Saniro1/Gamesir-G7-Pro-Gyro-Mount/docs/V28_README.md

# GameSir G7 Pro modular reversible gyro mount

**V28 is the current revision:** a smoothly rounded transition replaces the pointed V27 join. The **V27 box position**, **9 mm clips**, **5 mm receiver inset**, **8 mm upper-bridge clearance**, and **thin straight print supports** are retained.

The owner asked for a rounder, more natural-looking curve. V28 uses a rounded crown and a continuous swept-band return, keeping the box position and functional clearances from V27. The revised fit has not yet been physically tested; print the short hook coupon first.

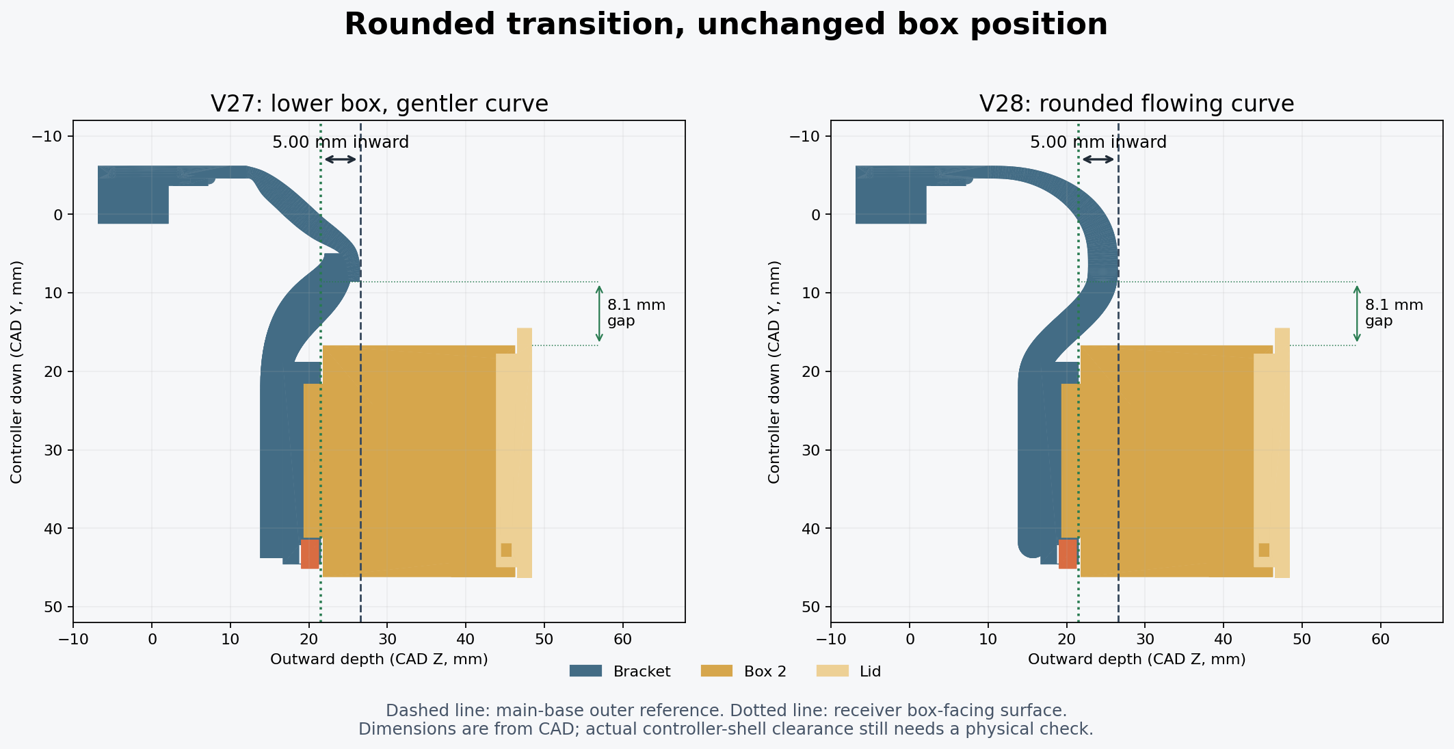
[picture p12: docs/V28_receiver_inset.png]
Receiver face inset relative to the main base


## Download and print

- [Snapmaker U1 0.4 mm / Snapmaker PLA Black — supported V28 3MF](slicer/Snapmaker_U1_PLA_Black_0.4_V28/G7_Modular_v28_U1_0.4_Snapmaker_PLA_Black_Supported.3mf)
- [Editable, unsliced V28 project](slicer/Snapmaker_U1_PLA_Black_0.4_V28/G7_Modular_v28_U1_0.4_Snapmaker_PLA_Black.3mf)
- [Complete V28 ZIP](releases/G7_Pro_Modular_Reversible_Box2_V28_Complete.zip)
- [Revised attachment STL](printable/G7_Modular_v28_g7_mount.stl) and [9 mm hook test STL](printable/G7_Modular_v28_hook_fit_coupon.stl)

Open the 3MF **as a project** in Snapmaker Orca 2.4.1 or newer. The supported file includes cached toolpaths and supports; inspect them in Preview. Re-slice if you change anything.

Plate 1 contains the revised hook test, receiver, dovetail coupon and key. Plate 2 contains the complete four-part assembly. **The Box 2 enclosure, lid, key and dovetail profile are unchanged from V23**; reuse those prints if you already have them. To print only the revised attachment, select that object and re-slice rather than sending the cached full-plate job.

## Current geometry

- Trimmed 1 mm from the free ends of both top clips: 10 mm becomes 9 mm. No global scaling or thinning of their sides.
- Lowered the complete dock/box/key installation 10 mm from V26, leaving it 30 mm above V23.
- Kept the receiver face 5 mm inward of the main-base reference. A rounded shared crown joins the upper bridge and lower links without the pointed V27 corner; the lower return has a consistent 3.8 mm side-profile thickness. Upper-bridge clearance remains at least 8 mm in both USB orientations.
- Removed the old long arms and lower dock, and joined the raised receiver with short structural arms.
- Used sparse straight rectilinear print supports (normal/snug, 3 mm line spacing), 0.32 mm separation and a sparse interface. No tree supports.

The structural arms are permanent parts of the attachment. The thin print supports shown in the slicer preview are removable. See [revision measurements and validation](docs/V28_REVISION.md) and [U1 setup details](slicer/Snapmaker_U1_PLA_Black_0.4_V28/README.md).

The controller shell, rear buttons, triggers and cable routes still need a physical check at this new position. Check the short hook first and then the complete mount without loading the device. PLA flexure durability and the strength of the bracket/key have not been physically verified.

## Files and history

V28 CAD is in [cad/G7_Pro_Modular_v28.scad](cad/G7_Pro_Modular_v28.scad); its seven STLs are in `printable/`, and both assembly views are in `assemblies/`. The V28 CAD reuses the frozen V24 9 mm clip geometry and V23 interface meshes. Its swept upper band tapers smoothly from the unchanged clip root to a rounded crown; the lower band flows from that shared crown to the receiver. The controller-contact clip surfaces remain unchanged.

The complete original V22 ZIP and all 13 extracted files remain unchanged under `originals/`. V23 through V27 source, prints and projects are retained for history, including the [V23 instructions](docs/V23_README.md). **Use V28 filenames for this revision.** No license was supplied with the original files; this import does not assert ownership or grant a new license.

## Rebuild

Use the existing checkout; no Git worktree is needed. Requires OpenSCAD 2021.01 and Python 3.12:

```bash
python -m venv .venv
.venv/bin/python -m pip install -r tools/requirements.txt
source .venv/bin/activate
./tools/build.sh 28
```

The build exports all seven V28 meshes and runs the geometry/assembly checks, writing `docs/validation_v28.json`. Explicitly use `./tools/build.sh 23` to reproduce the old version.

To regenerate the U1 projects and validate the saved file in the actual slicer:

```bash
.venv/bin/python tools/create_snapmaker_orca_project.py --design-version 28 \
  --resources /path/to/SnapmakerOrca/resources \
  --orca /path/to/snapmaker-orca --workdir /tmp/g7-u1-v28 --validate
python tools/package_release.py --design-version 28
```

The saved V28 project passed 84 project/slicing checks, and the V28 geometry passed 97 CAD checks. These establish model and slicer consistency, not physical fit or a load rating.
