Saniro1/Gamesir-G7-Pro-Gyro-Mount/docs/V27_comparison.png

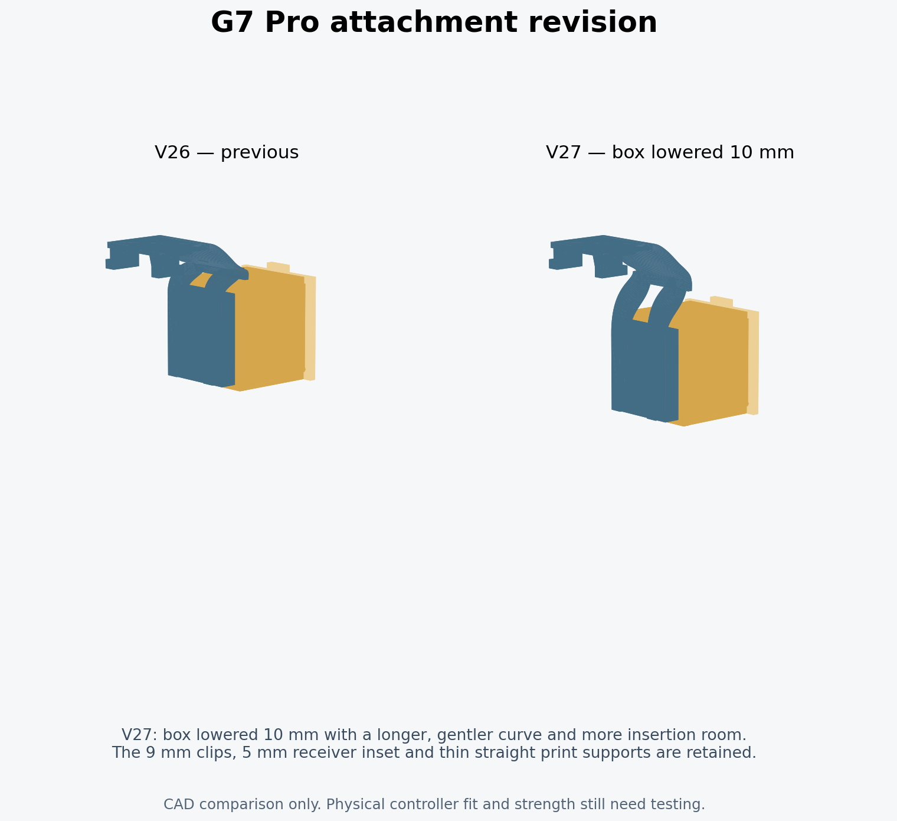
docs/V27_comparison.png
