Saniro1/Gamesir-G7-Pro-Gyro-Mount/originals/v22/G7_Modular_v22_USB_Up_Down_Preview.png

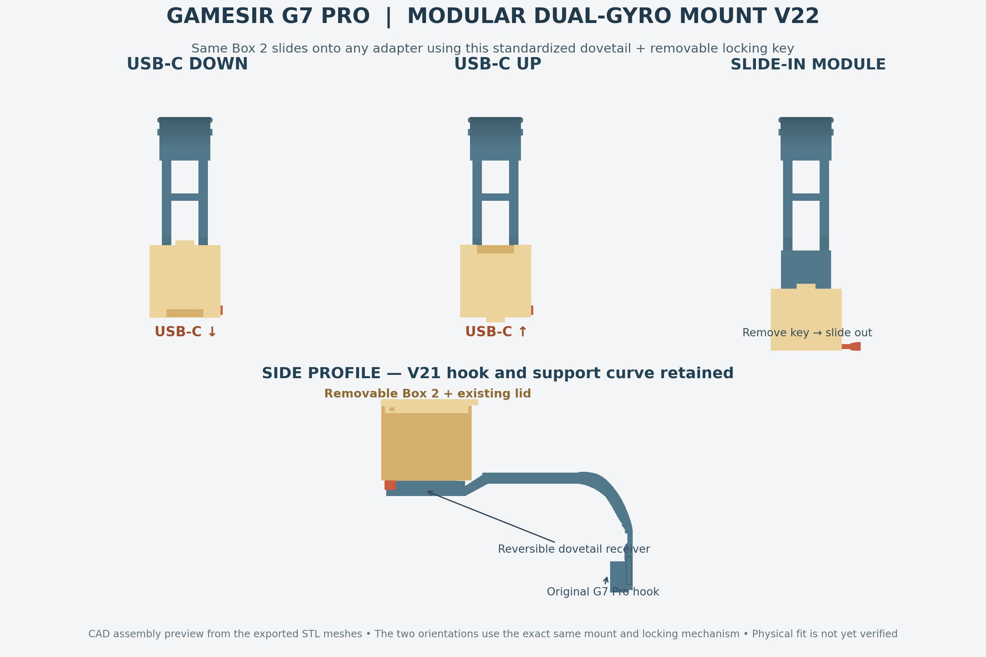
originals/v22/G7_Modular_v22_USB_Up_Down_Preview.png
