Saniro1/Gamesir-G7-Pro-Gyro-Mount/assemblies/G7_Modular_v34_Assembly_USB_Down.3mf

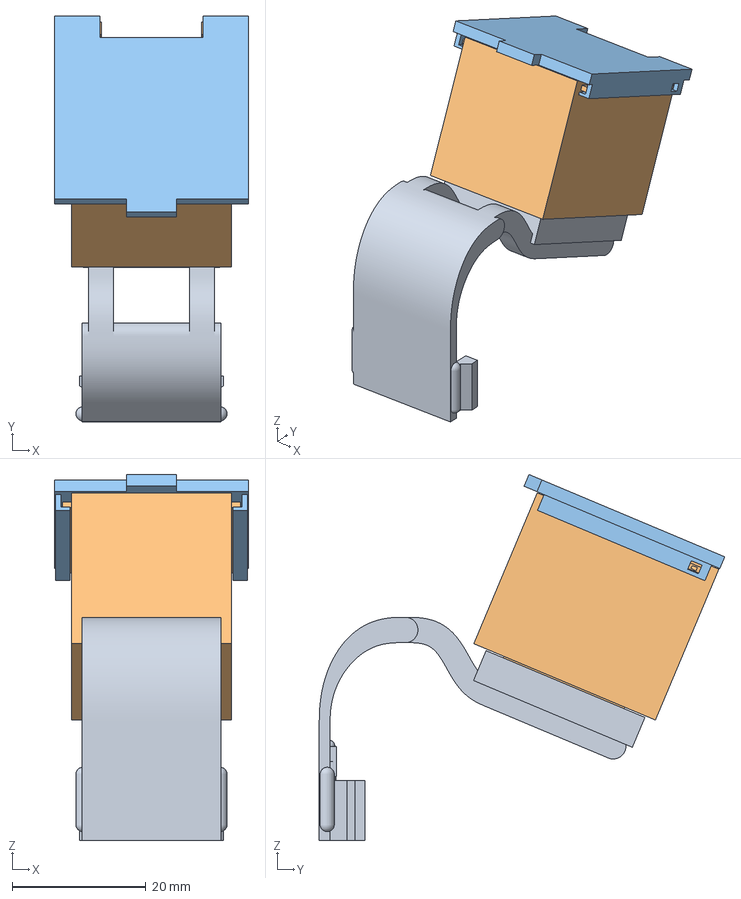
[picture p19: CAD file, 2026-11-11]
assemblies/G7_Modular_v34_Assembly_USB_Down.3mf
29.1 x 60.7 x 54.8 mm
g7_mount
lid
