Saniro1/Gamesir-G7-Pro-Gyro-Mount/originals/v22/G7_Modular_v22_Assembly_USB_Down.3mf

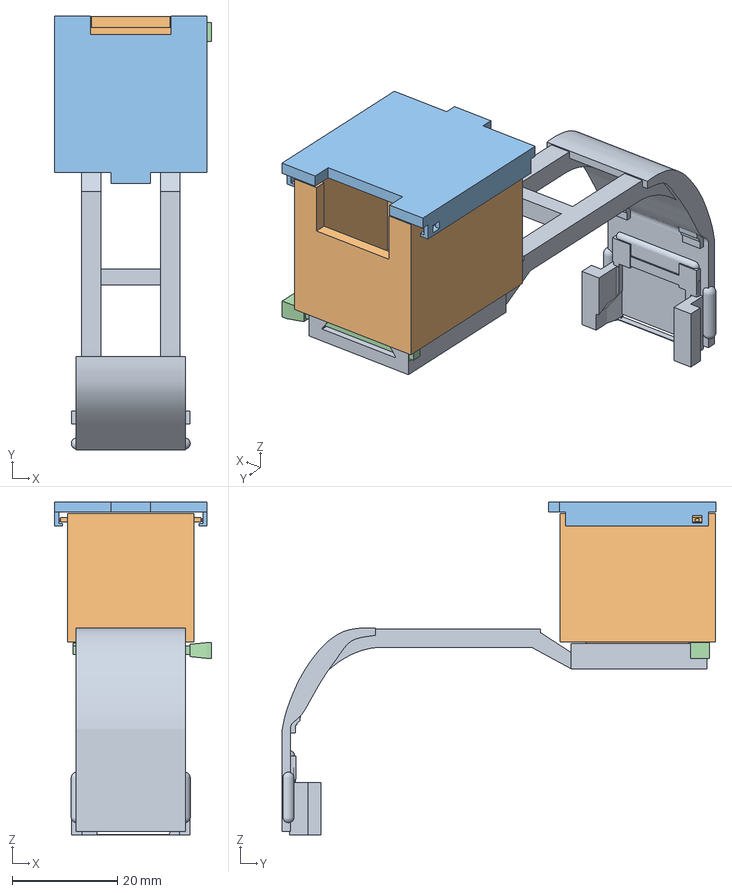
[picture p20: CAD file, 2026-11-05]
originals/v22/G7_Modular_v22_Assembly_USB_Down.3mf
29.9 x 82.5 x 63.4 mm
G7_dock
Box_2_universal_dovetail_reversible
Existing_sliding_lid
lock_key
