Saniro1/Gamesir-G7-Pro-Gyro-Mount/assemblies/G7_Modular_v34_Assembly_USB_Up.3mf

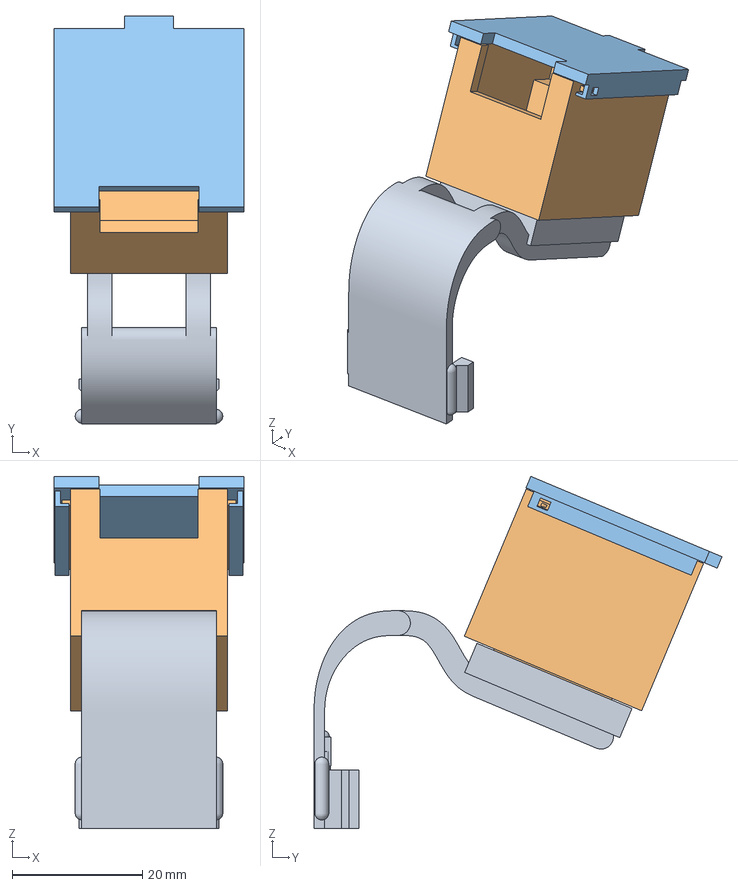
[picture p21: CAD file, 2026-11-11]
assemblies/G7_Modular_v34_Assembly_USB_Up.3mf
29.1 x 62.6 x 54.0 mm
g7_mount
lid
