Saniro1/Gamesir-G7-Pro-Gyro-Mount/cad/reference/mount_v22.stl

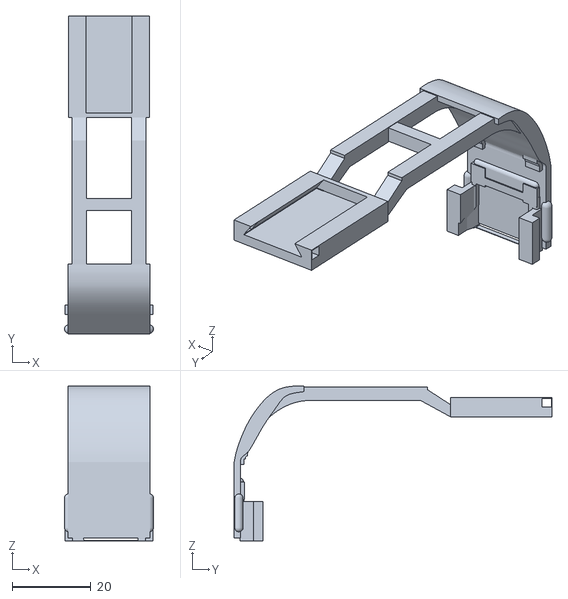
[picture p23: CAD file, 2026-11-05]
cad/reference/mount_v22.stl
22.6 x 80.8 x 39.4
