Saniro1/Gamesir-G7-Pro-Gyro-Mount/originals/v22/G7_Modular_v22_Print_Ready_4_Parts.3mf

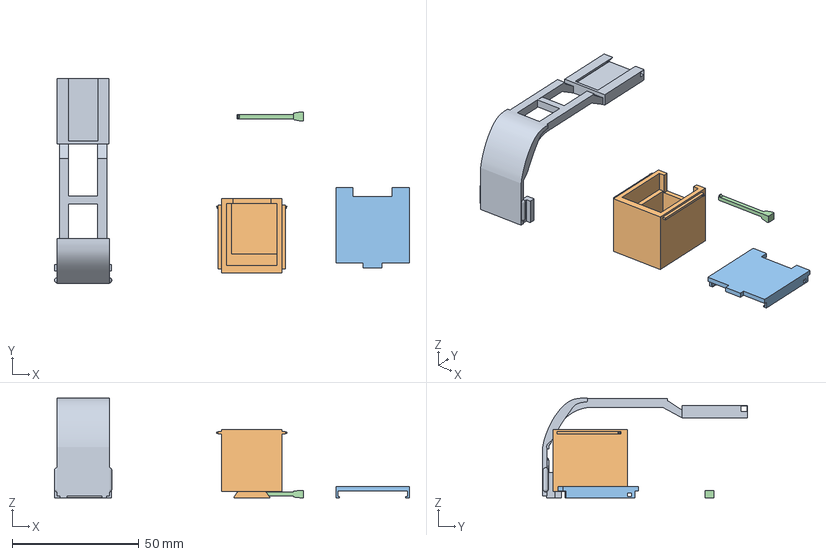
[picture p24: CAD file, 2026-11-05]
originals/v22/G7_Modular_v22_Print_Ready_4_Parts.3mf
140.1 x 80.8 x 39.4 mm
g7_mount
lid
lock_key
