Saniro1/Gamesir-G7-Pro-Gyro-Mount/printable/G7_Modular_v34_g7_mount.stl

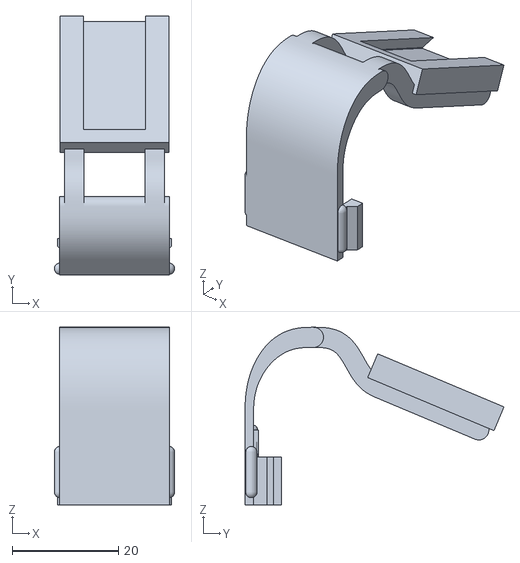
[picture p25: CAD file, 2026-11-11]
printable/G7_Modular_v34_g7_mount.stl
22.6 x 48.8 x 33.4
