Saniro1/Gamesir-G7-Pro-Gyro-Mount/slicer/Snapmaker_U1_IEMAI_Matte_PETG_Black_0.4_V32/G7_Modular_v32_U1_0.4_IEMAI_Matte_PETG_Black_Supported.3mf

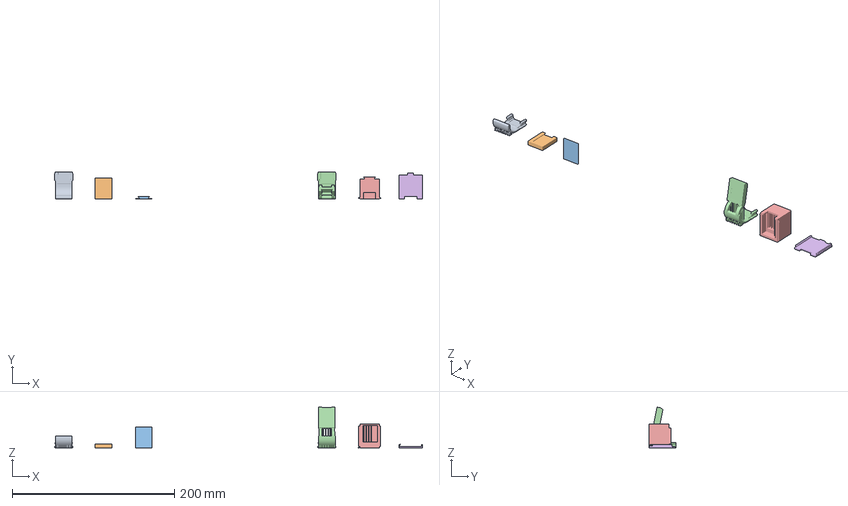
[picture p26: CAD file, 2026-11-10]
slicer/Snapmaker_U1_IEMAI_Matte_PETG_Black_0.4_V32/G7_Modular_v32_U1_0.4_IEMAI_Matte_PETG_Black_Supported.3mf
453.1 x 33.4 x 50.3 mm
hook_fit_coupon._1
universal_receiver._1
male_fit_coupon._1
g7_mount._1
lid._1
