Saniro1/Gamesir-G7-Pro-Gyro-Mount/slicer/Snapmaker_U1_PLA_Black_0.4_V34/custom_supports/g7_mount_peel_sheets.stl

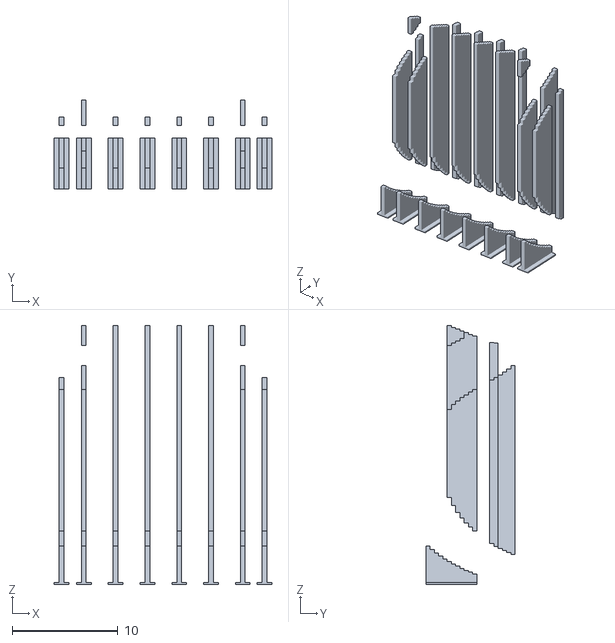
[picture p27: CAD file, 2026-11-11]
slicer/Snapmaker_U1_PLA_Black_0.4_V34/custom_supports/g7_mount_peel_sheets.stl
20.5 x 8.40 x 24.4
