Saniro1/Gamesir-G7-Pro-Gyro-Mount/slicer/Snapmaker_U1_PLA_Black_0.4_V34/G7_Modular_v34_U1_0.4_Snapmaker_PLA_Black.3mf

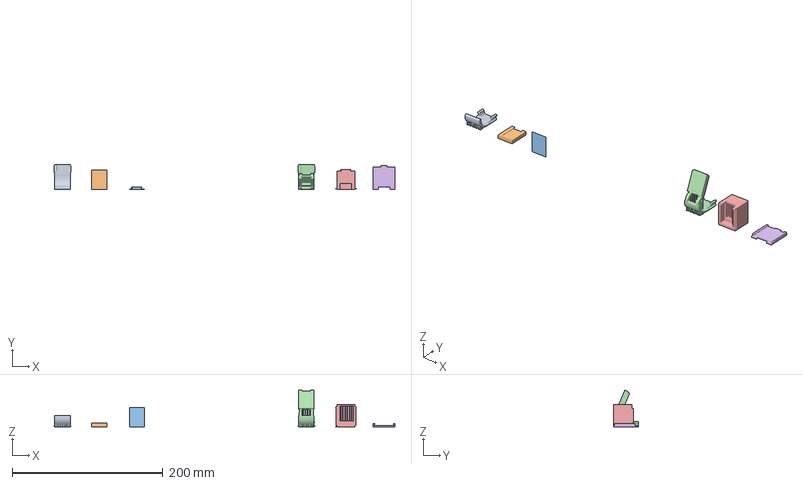
[picture p28: CAD file, 2026-11-11]
slicer/Snapmaker_U1_PLA_Black_0.4_V34/G7_Modular_v34_U1_0.4_Snapmaker_PLA_Black.3mf
453.1 x 33.4 x 48.8 mm
hook_fit_coupon._1
universal_receiver._1
male_fit_coupon._1
g7_mount._1
lid._1
