Saniro1/Gamesir-G7-Pro-Gyro-Mount/assemblies/G7_Modular_v34_Separated_6_Parts.3mf

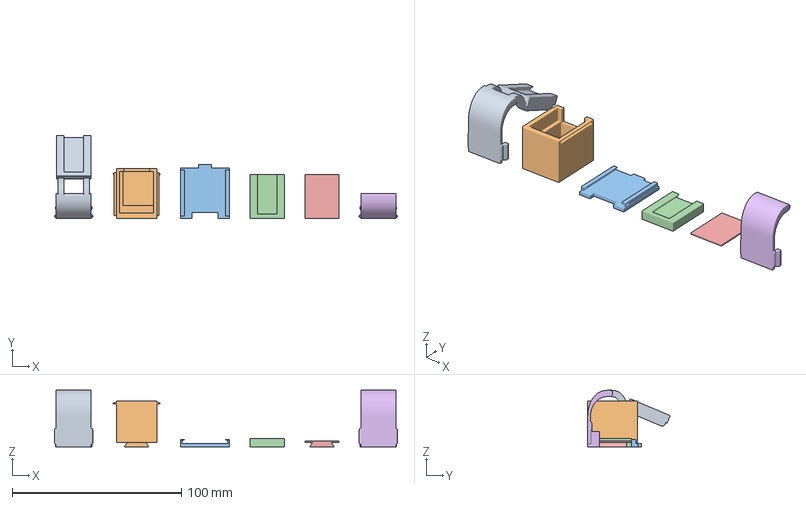
[picture p29: CAD file, 2026-11-11]
assemblies/G7_Modular_v34_Separated_6_Parts.3mf
202.6 x 48.8 x 33.4 mm
g7_mount
lid
universal_receiver
male_fit_coupon
hook_fit_coupon
