Saniro1/Gamesir-G7-Pro-Gyro-Mount/printable/G7_Modular_v34_lid.stl

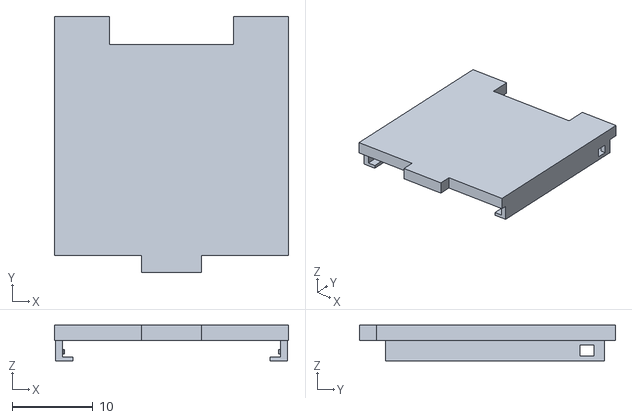
[picture p30: CAD file, 2026-11-11]
printable/G7_Modular_v34_lid.stl
29.1 x 31.8 x 4.45
