Saniro1/Gamesir-G7-Pro-Gyro-Mount/slicer/Snapmaker_U1_PLA_Black_0.4_V34/custom_supports/lid_peel_sheets.stl

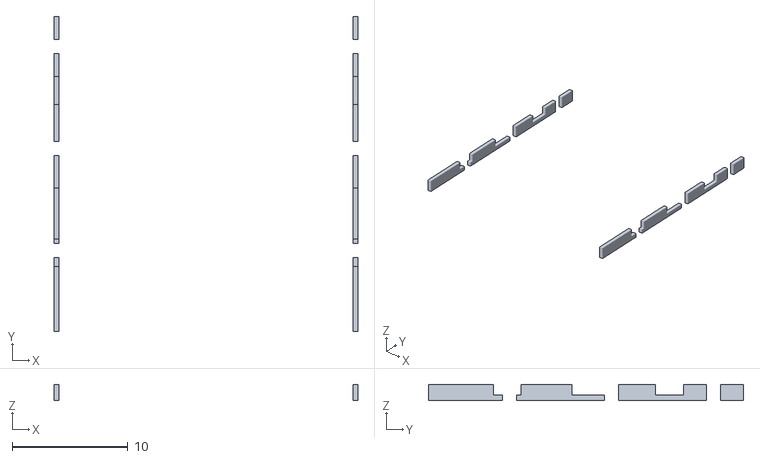
[picture p31: CAD file, 2026-11-11]
slicer/Snapmaker_U1_PLA_Black_0.4_V34/custom_supports/lid_peel_sheets.stl
26.2 x 27.2 x 1.41
