Saniro1/Gamesir-G7-Pro-Gyro-Mount/originals/v22/G7_Modular_v22_lock_key.stl

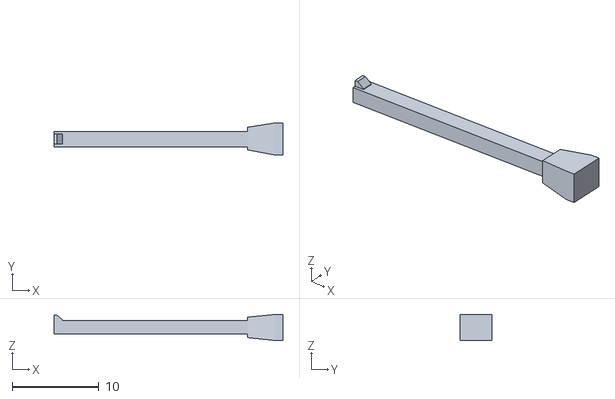
[picture p32: CAD file, 2026-11-05]
originals/v22/G7_Modular_v22_lock_key.stl
26.4 x 3.70 x 3.00
