Saniro1/Gamesir-G7-Pro-Gyro-Mount/printable/G7_Modular_v34_universal_receiver.stl

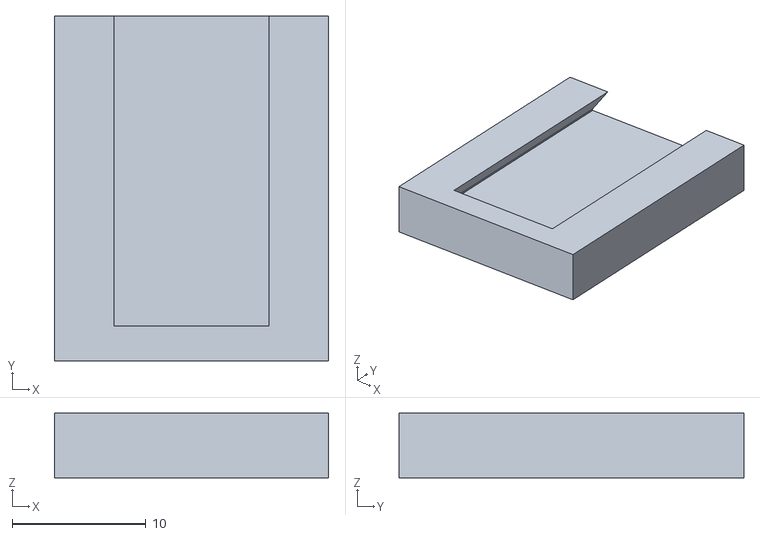
[picture p33: CAD file, 2026-11-10]
printable/G7_Modular_v34_universal_receiver.stl
20.5 x 25.8 x 4.85
