Saniro1/Gamesir-G7-Pro-Gyro-Mount/slicer/Snapmaker_U1_PLA_Black_0.4_V34/custom_supports/hook_fit_coupon_peel_sheets.stl

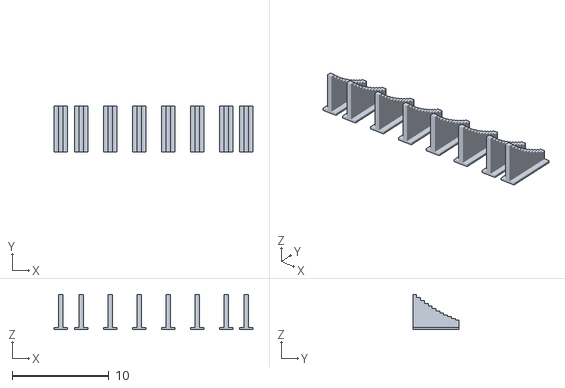
[picture p34: CAD file, 2026-11-10]
slicer/Snapmaker_U1_PLA_Black_0.4_V34/custom_supports/hook_fit_coupon_peel_sheets.stl
20.5 x 4.80 x 3.64
