Saniro1/Gamesir-G7-Pro-Gyro-Mount/originals/v22/G7_Modular_v22_universal_receiver.stl

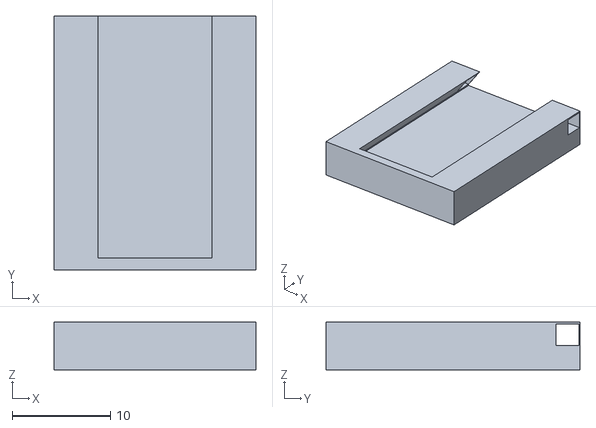
[picture p35: CAD file, 2026-11-05]
originals/v22/G7_Modular_v22_universal_receiver.stl
20.5 x 25.8 x 4.85
