Saniro1/Gamesir-G7-Pro-Gyro-Mount/slicer/Snapmaker_U1_PLA_Black_0.4_V34/custom_supports/male_fit_coupon_peel_sheets.stl

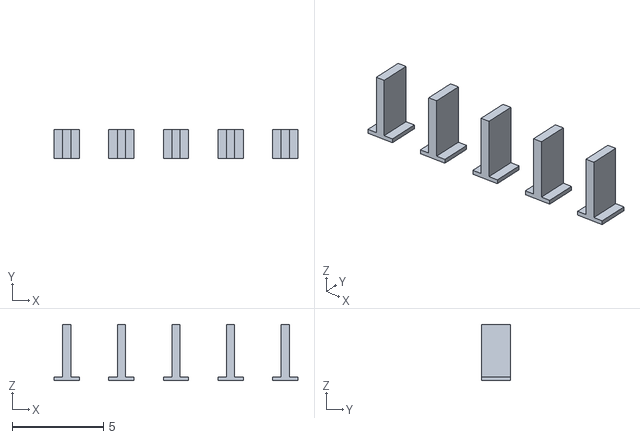
[picture p36: CAD file, 2026-11-10]
slicer/Snapmaker_U1_PLA_Black_0.4_V34/custom_supports/male_fit_coupon_peel_sheets.stl
13.4 x 1.60 x 3.08
