Saniro1/Gamesir-G7-Pro-Gyro-Mount/slicer/Snapmaker_U1_PLA_Black_0.4_V34/custom_supports/box_peel_sheets.stl

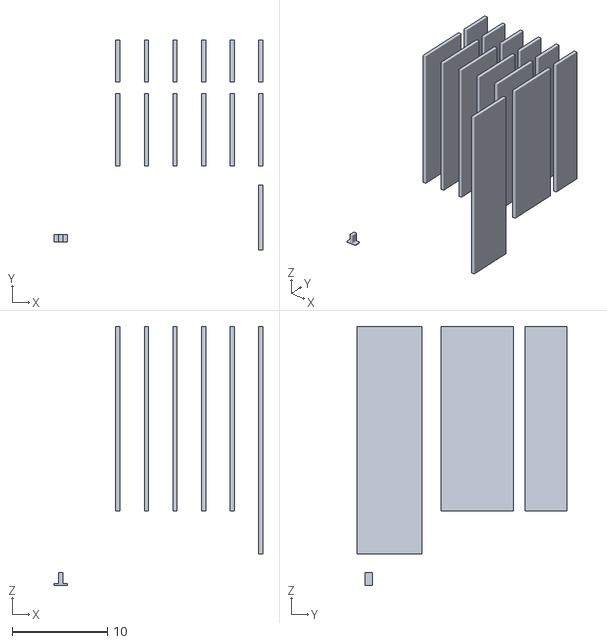
[picture p37: CAD file, 2026-11-10]
slicer/Snapmaker_U1_PLA_Black_0.4_V34/custom_supports/box_peel_sheets.stl
21.9 x 22.0 x 27.2
