Saniro1/Gamesir-G7-Pro-Gyro-Mount/printable/G7_Modular_v34_hook_fit_coupon.stl

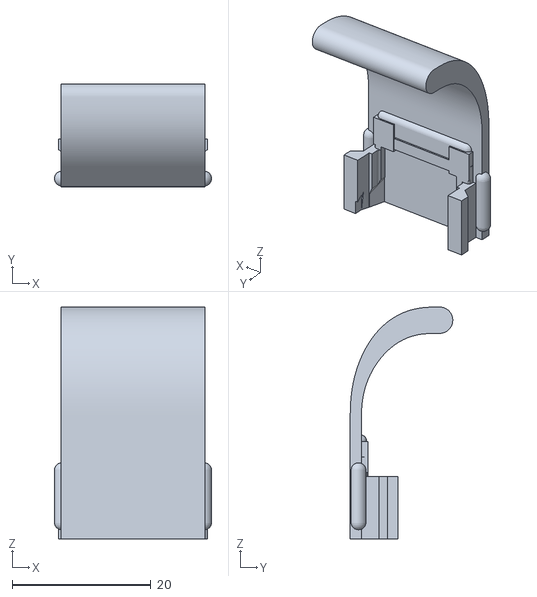
[picture p38: CAD file, 2026-11-10]
printable/G7_Modular_v34_hook_fit_coupon.stl
22.6 x 14.8 x 33.4
