Saniro1/Gamesir-G7-Pro-Gyro-Mount/printable/G7_Modular_v34_box.stl

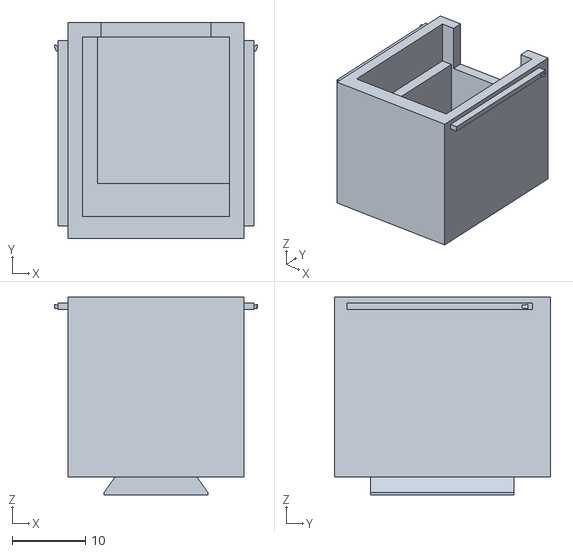
[picture p39: CAD file, 2026-11-10]
printable/G7_Modular_v34_box.stl
27.7 x 29.5 x 27.0
