Saniro1/Gamesir-G7-Pro-Gyro-Mount/assemblies/G7_Modular_v31_Separated_7_Parts.3mf

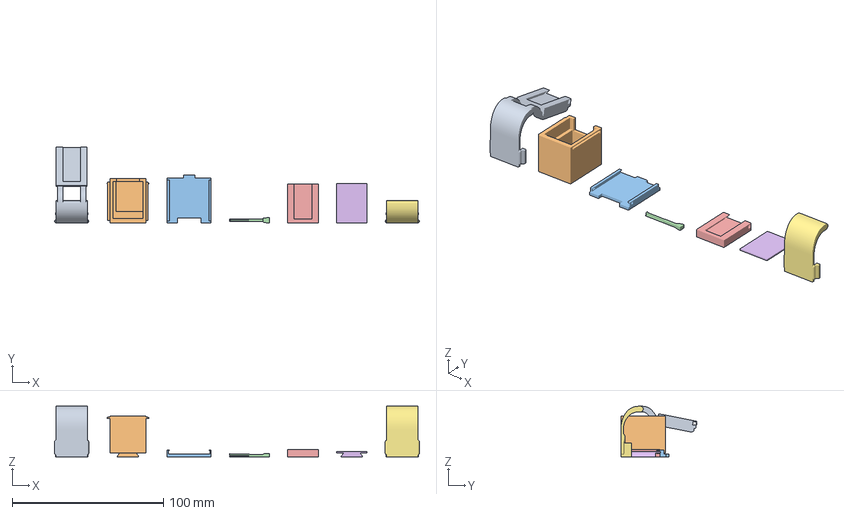
[picture p40: CAD file, 2026-11-10]
assemblies/G7_Modular_v31_Separated_7_Parts.3mf
240.9 x 50.3 x 33.4 mm
g7_mount
lid
lock_key
universal_receiver
male_fit_coupon
hook_fit_coupon
