Saniro1/Gamesir-G7-Pro-Gyro-Mount/printable/G7_Modular_v31_lock_key.stl

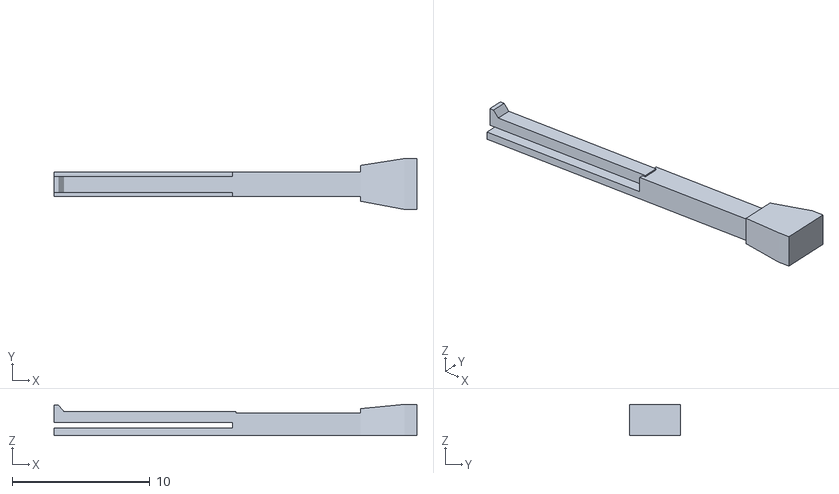
[picture p41: CAD file, 2026-11-10]
printable/G7_Modular_v31_lock_key.stl
26.3 x 3.70 x 2.27
