Saniro1/Gamesir-G7-Pro-Gyro-Mount/printable/G7_Modular_v34_male_fit_coupon.stl

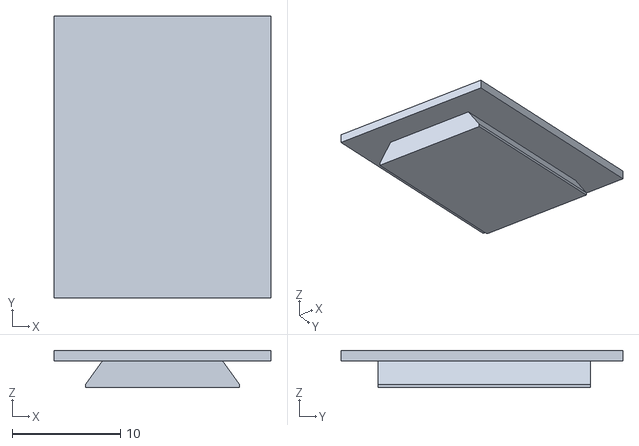
[picture p42: CAD file, 2026-11-10]
printable/G7_Modular_v34_male_fit_coupon.stl
20.0 x 26.0 x 3.45
