Saniro1/Gamesir-G7-Pro-Gyro-Mount/(list of files, cad)

Other CAD files:
slicer/Snapmaker_U1_IEMAI_Matte_PETG_Black_0.4_V32/G7_Modular_v32_U1_0.4_IEMAI_Matte_PETG_Black.3mf
slicer/Snapmaker_U1_PLA_Black_0.4_V34/G7_Modular_v34_U1_0.4_Snapmaker_PLA_Black_Supported.3mf
cad/G7_Pro_Modular_v23.scad
cad/G7_Pro_Modular_v24.scad
assemblies/G7_Modular_v23_Assembly_USB_Down.3mf
assemblies/G7_Modular_v23_Assembly_USB_Up.3mf
assemblies/G7_Modular_v23_Separated_7_Parts.3mf
assemblies/G7_Modular_v24_Assembly_USB_Down.3mf
assemblies/G7_Modular_v24_Assembly_USB_Up.3mf
assemblies/G7_Modular_v24_Separated_7_Parts.3mf
assemblies/G7_Modular_v25_Assembly_USB_Down.3mf
assemblies/G7_Modular_v25_Assembly_USB_Up.3mf
assemblies/G7_Modular_v25_Separated_7_Parts.3mf
assemblies/G7_Modular_v26_Assembly_USB_Down.3mf
assemblies/G7_Modular_v26_Assembly_USB_Up.3mf
assemblies/G7_Modular_v26_Separated_7_Parts.3mf
assemblies/G7_Modular_v27_Assembly_USB_Down.3mf
assemblies/G7_Modular_v27_Assembly_USB_Up.3mf
assemblies/G7_Modular_v27_Separated_7_Parts.3mf
assemblies/G7_Modular_v28_Assembly_USB_Down.3mf
assemblies/G7_Modular_v28_Assembly_USB_Up.3mf
assemblies/G7_Modular_v28_Separated_7_Parts.3mf
assemblies/G7_Modular_v29_Assembly_USB_Down.3mf
assemblies/G7_Modular_v29_Assembly_USB_Up.3mf
assemblies/G7_Modular_v29_Separated_7_Parts.3mf
assemblies/G7_Modular_v30_Assembly_USB_Down.3mf
assemblies/G7_Modular_v30_Assembly_USB_Up.3mf
assemblies/G7_Modular_v30_Separated_7_Parts.3mf
assemblies/G7_Modular_v31_Assembly_USB_Down.3mf
assemblies/G7_Modular_v31_Assembly_USB_Up.3mf
assemblies/G7_Modular_v32_Assembly_USB_Down.3mf
assemblies/G7_Modular_v32_Assembly_USB_Up.3mf
assemblies/G7_Modular_v32_Separated_6_Parts.3mf
assemblies/G7_Modular_v33_Assembly_USB_Down.3mf
assemblies/G7_Modular_v33_Assembly_USB_Up.3mf
assemblies/G7_Modular_v33_Separated_6_Parts.3mf
cad/G7_Pro_Modular_v25.scad
cad/G7_Pro_Modular_v26.scad
cad/G7_Pro_Modular_v27.scad
cad/G7_Pro_Modular_v28.scad
cad/G7_Pro_Modular_v29.scad
cad/G7_Pro_Modular_v30.scad
cad/G7_Pro_Modular_v31.scad
cad/G7_Pro_Modular_v32.scad
cad/G7_Pro_Modular_v33.scad
printable/G7_Modular_v23_g7_mount.stl
printable/G7_Modular_v23_hook_fit_coupon.stl
printable/G7_Modular_v24_g7_mount.stl
printable/G7_Modular_v24_hook_fit_coupon.stl
printable/G7_Modular_v25_g7_mount.stl
printable/G7_Modular_v25_hook_fit_coupon.stl
printable/G7_Modular_v26_g7_mount.stl
printable/G7_Modular_v26_hook_fit_coupon.stl
printable/G7_Modular_v27_g7_mount.stl
printable/G7_Modular_v27_hook_fit_coupon.stl
printable/G7_Modular_v28_box.stl
printable/G7_Modular_v28_g7_mount.stl
printable/G7_Modular_v28_hook_fit_coupon.stl
printable/G7_Modular_v28_lid.stl
printable/G7_Modular_v28_lock_key.stl
printable/G7_Modular_v28_male_fit_coupon.stl
printable/G7_Modular_v28_universal_receiver.stl
printable/G7_Modular_v29_g7_mount.stl
printable/G7_Modular_v29_hook_fit_coupon.stl
printable/G7_Modular_v31_g7_mount.stl
printable/G7_Modular_v31_lid.stl
printable/G7_Modular_v31_universal_receiver.stl
printable/G7_Modular_v32_lid.stl
printable/G7_Modular_v33_g7_mount.stl
slicer/Snapmaker_U1_IEMAI_Matte_PETG_Black_0.4_V29/G7_Modular_v29_U1_0.4_IEMAI_Matte_PETG_Black.3mf
slicer/Snapmaker_U1_IEMAI_Matte_PETG_Black_0.4_V29/G7_Modular_v29_U1_0.4_IEMAI_Matte_PETG_Black_Supported.3mf
slicer/Snapmaker_U1_IEMAI_Matte_PETG_Black_0.4_V30/G7_Modular_v30_U1_0.4_IEMAI_Matte_PETG_Black.3mf
slicer/Snapmaker_U1_IEMAI_Matte_PETG_Black_0.4_V30/G7_Modular_v30_U1_0.4_IEMAI_Matte_PETG_Black_Supported.3mf
slicer/Snapmaker_U1_IEMAI_Matte_PETG_Black_0.4_V31/G7_Modular_v31_U1_0.4_IEMAI_Matte_PETG_Black.3mf
slicer/Snapmaker_U1_IEMAI_Matte_PETG_Black_0.4_V31/G7_Modular_v31_U1_0.4_IEMAI_Matte_PETG_Black_Supported.3mf
slicer/Snapmaker_U1_IEMAI_Matte_PETG_Black_0.4_V31/custom_supports/lock_key_peel_sheets.stl
slicer/Snapmaker_U1_PLA_Black_0.4/G7_Modular_v23_U1_0.4_Snapmaker_PLA_Black.3mf
slicer/Snapmaker_U1_PLA_Black_0.4/G7_Modular_v23_U1_0.4_Snapmaker_PLA_Black_Supported.3mf
slicer/Snapmaker_U1_PLA_Black_0.4_V24/G7_Modular_v24_U1_0.4_Snapmaker_PLA_Black.3mf
slicer/Snapmaker_U1_PLA_Black_0.4_V24/G7_Modular_v24_U1_0.4_Snapmaker_PLA_Black_Supported.3mf
slicer/Snapmaker_U1_PLA_Black_0.4_V25/G7_Modular_v25_U1_0.4_Snapmaker_PLA_Black.3mf
slicer/Snapmaker_U1_PLA_Black_0.4_V25/G7_Modular_v25_U1_0.4_Snapmaker_PLA_Black_Supported.3mf
slicer/Snapmaker_U1_PLA_Black_0.4_V26/G7_Modular_v26_U1_0.4_Snapmaker_PLA_Black.3mf
slicer/Snapmaker_U1_PLA_Black_0.4_V26/G7_Modular_v26_U1_0.4_Snapmaker_PLA_Black_Supported.3mf
slicer/Snapmaker_U1_PLA_Black_0.4_V27/G7_Modular_v27_U1_0.4_Snapmaker_PLA_Black.3mf
slicer/Snapmaker_U1_PLA_Black_0.4_V27/G7_Modular_v27_U1_0.4_Snapmaker_PLA_Black_Supported.3mf
slicer/Snapmaker_U1_PLA_Black_0.4_V28/G7_Modular_v28_U1_0.4_Snapmaker_PLA_Black.3mf
slicer/Snapmaker_U1_PLA_Black_0.4_V28/G7_Modular_v28_U1_0.4_Snapmaker_PLA_Black_Supported.3mf
slicer/Snapmaker_U1_PLA_Black_0.4_V32/G7_Modular_v32_U1_0.4_Snapmaker_PLA_Black.3mf
slicer/Snapmaker_U1_PLA_Black_0.4_V32/G7_Modular_v32_U1_0.4_Snapmaker_PLA_Black_Supported.3mf
slicer/Snapmaker_U1_PLA_Black_0.4_V33/G7_Modular_v33_U1_0.4_Snapmaker_PLA_Black.3mf
slicer/Snapmaker_U1_PLA_Black_0.4_V33/G7_Modular_v33_U1_0.4_Snapmaker_PLA_Black_Supported.3mf
