Saniro1/Gamesir-G7-Pro-Gyro-Mount/(commit log)

2026-11-05 Import complete V22 archive and add CAD-validated V23 mount repairs
    [G7_Modular_v22_Assembly_USB_Down.3mf, G7_Modular_v22_Assembly_USB_Up.3mf, G7_Modular_v22_Print_Ready_4_Parts.3mf, G7_Modular_v22_box.stl, G7_Modular_v22_g7_mount.stl, G7_Modular_v22_lid.stl, G7_Modular_v22_lock_key.stl, G7_Modular_v22_male_fit_coupon.stl]
2026-11-09 Add validated Snapmaker U1 black PLA print project
    [G7_Modular_v23_U1_0.4_Snapmaker_PLA_Black.3mf]
2026-11-09 Improve print orientations and embed removable support toolpaths
    [G7_Modular_v23_U1_0.4_Snapmaker_PLA_Black.3mf, G7_Modular_v23_U1_0.4_Snapmaker_PLA_Black_Supported.3mf]
2026-11-09 Use thin tree supports with easier-release interfaces
    [G7_Modular_v23_U1_0.4_Snapmaker_PLA_Black.3mf, G7_Modular_v23_U1_0.4_Snapmaker_PLA_Black_Supported.3mf]
2026-11-09 Add V24 with 9 mm clips, raised dock and thin straight supports
    [G7_Modular_v24_Assembly_USB_Down.3mf, G7_Modular_v24_Assembly_USB_Up.3mf, G7_Modular_v24_Separated_7_Parts.3mf, G7_Modular_v24_U1_0.4_Snapmaker_PLA_Black.3mf, G7_Modular_v24_U1_0.4_Snapmaker_PLA_Black_Supported.3mf, G7_Modular_v24_box.stl, G7_Modular_v24_g7_mount.stl, G7_Modular_v24_hook_fit_coupon.stl]
2026-11-10 Restore curved bridge and recess V25 dock by 5 mm
    [G7_Modular_v25_Assembly_USB_Down.3mf, G7_Modular_v25_Assembly_USB_Up.3mf, G7_Modular_v25_Separated_7_Parts.3mf, G7_Modular_v25_U1_0.4_Snapmaker_PLA_Black.3mf, G7_Modular_v25_U1_0.4_Snapmaker_PLA_Black_Supported.3mf, G7_Modular_v25_box.stl, G7_Modular_v25_g7_mount.stl, G7_Modular_v25_hook_fit_coupon.stl]
2026-11-10 Recess V26 receiver face 5 mm inside the main base
    [G7_Modular_v26_Assembly_USB_Down.3mf, G7_Modular_v26_Assembly_USB_Up.3mf, G7_Modular_v26_Separated_7_Parts.3mf, G7_Modular_v26_U1_0.4_Snapmaker_PLA_Black.3mf, G7_Modular_v26_U1_0.4_Snapmaker_PLA_Black_Supported.3mf, G7_Modular_v26_box.stl, G7_Modular_v26_g7_mount.stl, G7_Modular_v26_hook_fit_coupon.stl]
2026-11-10 Lower V27 box by 10 mm and relax the curved transition
    [G7_Modular_v27_Assembly_USB_Down.3mf, G7_Modular_v27_Assembly_USB_Up.3mf, G7_Modular_v27_Separated_7_Parts.3mf, G7_Modular_v27_U1_0.4_Snapmaker_PLA_Black.3mf, G7_Modular_v27_U1_0.4_Snapmaker_PLA_Black_Supported.3mf, G7_Modular_v27_box.stl, G7_Modular_v27_g7_mount.stl, G7_Modular_v27_hook_fit_coupon.stl]
2026-11-10 Round V28 transition with a smooth shared crown and swept return
    [G7_Modular_v28_Assembly_USB_Down.3mf, G7_Modular_v28_Assembly_USB_Up.3mf, G7_Modular_v28_Separated_7_Parts.3mf, G7_Modular_v28_U1_0.4_Snapmaker_PLA_Black.3mf, G7_Modular_v28_U1_0.4_Snapmaker_PLA_Black_Supported.3mf, G7_Modular_v28_box.stl, G7_Modular_v28_g7_mount.stl, G7_Modular_v28_hook_fit_coupon.stl]
2026-11-10 Tilt V29 slider inward and add open-top U1 matte PETG print project
    [G7_Modular_v29_Assembly_USB_Down.3mf, G7_Modular_v29_Assembly_USB_Up.3mf, G7_Modular_v29_Separated_7_Parts.3mf, G7_Modular_v29_U1_0.4_IEMAI_Matte_PETG_Black.3mf, G7_Modular_v29_U1_0.4_IEMAI_Matte_PETG_Black_Supported.3mf, G7_Modular_v29_box.stl, G7_Modular_v29_g7_mount.stl, G7_Modular_v29_hook_fit_coupon.stl]
2026-11-10 Reduce V30 clip cross-sections without shortening and ease PETG supports
    [G7_Modular_v30_Assembly_USB_Down.3mf, G7_Modular_v30_Assembly_USB_Up.3mf, G7_Modular_v30_Separated_7_Parts.3mf, G7_Modular_v30_U1_0.4_IEMAI_Matte_PETG_Black.3mf, G7_Modular_v30_U1_0.4_IEMAI_Matte_PETG_Black_Supported.3mf, G7_Modular_v30_box.stl, G7_Modular_v30_g7_mount.stl, G7_Modular_v30_hook_fit_coupon.stl]
2026-11-10 Replace V31 support blocks with separate single-bead peel sheets
    [G7_Modular_v31_Assembly_USB_Down.3mf, G7_Modular_v31_Assembly_USB_Up.3mf, G7_Modular_v31_Separated_7_Parts.3mf, G7_Modular_v31_U1_0.4_IEMAI_Matte_PETG_Black.3mf, G7_Modular_v31_U1_0.4_IEMAI_Matte_PETG_Black_Supported.3mf, G7_Modular_v31_box.stl, G7_Modular_v31_g7_mount.stl, G7_Modular_v31_hook_fit_coupon.stl]
2026-11-10 Tighten V32 sliding lid and remove receiver locking key and slot
    [G7_Modular_v32_Assembly_USB_Down.3mf, G7_Modular_v32_Assembly_USB_Up.3mf, G7_Modular_v32_Separated_6_Parts.3mf, G7_Modular_v32_U1_0.4_IEMAI_Matte_PETG_Black.3mf, G7_Modular_v32_U1_0.4_IEMAI_Matte_PETG_Black_Supported.3mf, G7_Modular_v32_box.stl, G7_Modular_v32_g7_mount.stl, G7_Modular_v32_hook_fit_coupon.stl]
2026-11-11 Add validated Snapmaker PLA Black setup for V32 U1 project
    [G7_Modular_v32_U1_0.4_Snapmaker_PLA_Black.3mf, G7_Modular_v32_U1_0.4_Snapmaker_PLA_Black_Supported.3mf, box_peel_sheets.stl, g7_mount_peel_sheets.stl, hook_fit_coupon_peel_sheets.stl, male_fit_coupon_peel_sheets.stl]
2026-11-11 Extend V33 lid rail hooks and support the longer lips in PLA project
    [G7_Modular_v33_Assembly_USB_Down.3mf, G7_Modular_v33_Assembly_USB_Up.3mf, G7_Modular_v33_Separated_6_Parts.3mf, G7_Modular_v33_U1_0.4_Snapmaker_PLA_Black.3mf, G7_Modular_v33_U1_0.4_Snapmaker_PLA_Black_Supported.3mf, G7_Modular_v33_box.stl, G7_Modular_v33_g7_mount.stl, G7_Modular_v33_hook_fit_coupon.stl]
2026-11-11 Tilt V34 lower receiver another 5 mm toward controller
    [G7_Modular_v34_Assembly_USB_Down.3mf, G7_Modular_v34_Assembly_USB_Up.3mf, G7_Modular_v34_Separated_6_Parts.3mf, G7_Modular_v34_U1_0.4_Snapmaker_PLA_Black.3mf, G7_Modular_v34_U1_0.4_Snapmaker_PLA_Black_Supported.3mf, G7_Modular_v34_box.stl, G7_Modular_v34_g7_mount.stl, G7_Modular_v34_hook_fit_coupon.stl]
